kimjinhwa/PoscoYard_PCM/(list of files, drawings)

Other design files:
PCM_BMS_V2.DSN
pcm_bms_v2.opj
