kimjinhwa/PoscoYard_PCM/(commit log)

2025-07-21 Modbus Address 변경시 자동으로 등록되도록 함.
    [PCM_BMS_V2.DSN, partitions.csv, pcm_bms_v2.opj]
2025-07-22 모든 기능을 구현 함.
    [default_8MB.csv]
2025-07-22 전류를 Float로 변경
    [pcm_bms_v2.opj]
2025-07-22 업데이트 할때 LED를 깜빡이게 함.
2025-07-23 F04에 Ampere 값을 추가 하였다.
2025-07-24 온도 컷오프 값을 추가 하였다.
    [pcm_bms_v2.opj]
2025-07-24 온토 컷오프는 의미 없다. 서버가 시키는대로 한다.
2025-07-25 전류에 10 배수하여 모드버스에 전달한다.
    [pcm_bms_v2.opj]
2025-07-25 ampereAverate를 세마포어로 설정한다.
2025-07-25 bug 해결
2025-07-29 Ampere 읽기를 2ms 로 변경
2025-07-29 전류에 의한 제어로직을 제거한다
2025-07-30 SOC 값을 추가 하였다.
2026-01-13 AmpRead초기화 부분변경
    [pcm_bms_v2.opj]
2026-01-13 AmpRead부분을 변경한다.
